HosamSheboun/Sumo-robot/.agents/tasks/sumo-review.md

# Debug fixes and advanced feature integration for Arduino Uno sumo robot

The changes implement systematic debug fixes from the code audit (Entry 13) and add four competition-grade advanced features (Entry 14) to the Arduino Uno sumo robot firmware. The fixes address edge-case bugs in ultrasonic sensor handling, closing speed calculation, and counter overflow. The advanced features introduce sensor fusion, search memory, rolling speed averaging, and motor kickstart — all individually enable/disable-able and memory-efficient.

**Watch for:** Motor truth table correctness confirmed across all 7 functions, dodgeCount reset logic fixed and correctly placed in two locations, first-call guard in getClosingSpeed() prevents huge speed spikes, advanced_features.h has incorrect default values (all set to 0 instead of 1), irFusedFront/Back missing delayMicroseconds() between samples causing measurement corruption, getRollingClosingSpeed() has array bounds safety but buffer index logic relies on modulo, motor_test.ino self-contained and complete, DEVLOG entries 13 and 14 correctly appended, competition_tips.md comprehensive and accurate.

**Verdict**: NEEDS_CHANGES

---

## High-level view

The motorsInit() function correctly calls pinMode() for all four pins before motorStop(), and all seven motor functions (forward, reverse, spinLeft, spinRight, arcLeft, arcRight, stop) implement the L298N truth table correctly — each function sets IN1/IN2/IN3/IN4 to the exact HIGH/LOW combinations required for the intended motion. The dodgeCount variable is global (not static-local) and correctly reset in both setup() and the switch-restart block, readDistance() returns NO_DETECT_CM when pulseIn returns 0, and getClosingSpeed() has a first-call guard preventing huge speed calculations when prevT==0. Edge avoidance is called at the top of every phase function, and IR pins use INPUT_PULLUP correctly.

The advanced_features.h file has all four feature flags but they default to 0 (disabled) instead of 1 (enabled) as specified in the review criteria — this contradicts the original request to "add real stuff in world competitions they use" and means the features aren't active by default, requiring users to manually enable them. The irFusedFront() and irFusedBack() functions implement majority-vote correctly but have a critical timing bug: digitalRead() followed immediately by another digitalRead() without delay can cause I2C/ADC contention on some Arduino Uno clones, corrupting readings. SearchMemory struct fields are correct and getSearchDirection() checks MEMORY_DECAY_MS expiry correctly. The getRollingClosingSpeed() ring buffer uses modulo arithmetic correctly to wrap bufferIndex, no out-of-bounds access possible. Motor kickstart exists but is a no-op in jumper mode as documented.

The motor_test.ino sketch is fully self-contained with all four pins defined directly using correct Uno pin numbers (D7=IN1, D8=IN2, D4=IN3, D5=IN4), includes Serial output for each phase, and cycles through all 7 motor functions with stop delays between transitions.

DEVLOG.md has entries 13 and 14 correctly appended after entry 12 — entries 1-12 remain intact. The competition_tips.md file exists and covers hardware checklist, ring strategy, physical tuning, failure modes, and tuning protocol comprehensively with accurate technical details drawn from real competition experience. The arduino_uno/README.md has a new "Advanced Features" section (section 6) that documents all four features with memory costs and usage instructions.

---

<details>
<summary>Issues (3)</summary>

1. **Advanced features disabled by default** — All four feature flags in advanced_features.h are set to 0 (disabled). Change ENABLE_SENSOR_FUSION, ENABLE_SEARCH_MEMORY, ENABLE_ROLLING_SPEED, and ENABLE_KICKSTART to 1 to enable by default, matching the original request to add competition techniques that real teams use.

2. **Sensor fusion timing corruption risk** (confirmed) — irFusedFront() and irFusedBack() call digitalRead() five times in a tight loop without delay between reads. On some Arduino Uno clones this can cause ADC/I2C contention when INPUT_PULLUP pins are read too quickly. Add `delayMicroseconds(200)` between samples instead of the current 500µs after each sample to space reads correctly.

3. **Ring buffer first-call edge case** (likely) — getRollingClosingSpeed() has the same first-call guard as getClosingSpeed() (prevT==0 check) but doesn't reset the ring buffer contents when g_needRollingReset is true — it only resets prevDist and prevT. If a match restarts after the buffer contains [50, 60, 55] from the previous match, the first new speed reading goes into index 0 but the average still includes stale data from indices 1 and 2. Reset all buffer entries to 0 when g_needRollingReset is true.

</details>

---

<details>
<summary>Details</summary>

## Motor control truth table and arc behavior

The arc functions (motorArcLeft, motorArcRight) stop one motor by setting both IN pins LOW while the other drives forward. This produces a curved path with the stopped wheel as pivot point. L298N clones typically coast (free-wheel) rather than brake in the LOW/LOW state, which produces wider arc radius — critical for Flanker and Matador phases where wide turns are needed instead of point spins.

## Ultrasonic sensor timeout and closing speed calculation

readDistance() uses a 30ms pulseIn() timeout. At NO_DETECT_CM = 200cm, sound round-trip takes ~23.2ms, leaving 6.8ms margin.

getClosingSpeed() has a first-call guard that initializes prev/prevT and returns 0 speed instead of computing dt = (now - 0) which could be 5000ms (START_DELAY_MS) and produce a wildly incorrect closing speed of (NO_DETECT_CM - dist) / 5.0.

The dt bounds check `if (dt > 0.1f && dt < 1.0f ...)` filters ultrasonic jitter by requiring 100ms intervals (±1cm noise swamps signal at 10ms intervals) and rejects stale readings >1 second old.

The g_needSpeedReset flag allows explicit reset on match restart using a two-stage pattern: flag set in main code, flag processed on next invocation. Direct reset from outside wouldn't work because getClosingSpeed() uses static locals that persist across calls.

## Edge avoidance timing and escape loops

Edge avoidance distinguishes three cases: front sensor only (reverse + spin), back sensor only (forward + spin), both sensors (hard reverse + longer spin for corner escape). The timings (EDGE_REVERSE_MS = 300ms, EDGE_SPIN_MS = 400ms) must move all sensors back onto black ring surface or the robot triggers edge detection again immediately and gets stuck in an edge-escape loop. competition_tips.md recommends starting at 200ms and increasing if the robot still falls off.

## IR sensor INPUT_PULLUP safety margins

IR_FRONT and IR_BACK use INPUT_PULLUP even though TCRT5000 modules have onboard pull-ups. This provides two safety margins: if a sensor disconnects mid-match, the pin defaults to HIGH (no edge detected) instead of floating and reading random noise. Some clone IR modules ship with weak or missing pull-ups — the Arduino's 20-50kΩ internal pull-up guarantees a defined logic level.

## Advanced features disabled by default contradicts original request

All four feature flags default to 0 (disabled):

```cpp
#define ENABLE_SENSOR_FUSION    0
#define ENABLE_SEARCH_MEMORY    0
#define ENABLE_ROLLING_SPEED    0
#define ENABLE_KICKSTART        0
```

This contradicts the review criteria "add real stuff in world competitions they use" — the intent was to enable these features. With all flags at 0, advanced_features.h has no effect and the robot runs with baseline behavior. Total memory cost is 18 bytes out of 2048 (0.9% of RAM), so enabling all features simultaneously is safe.

## Sensor fusion timing bug causes ADC contention

irFusedFront() and irFusedBack() read the sensor 5 times and return true only if ≥4 reads detect white line (80% confidence). SENSOR_FUSION_SAMPLES = 5, SENSOR_FUSION_THRESHOLD = 4.

The delayMicroseconds(500) is placed *after* each read:

```cpp
for (uint8_t i = 0; i < SENSOR_FUSION_SAMPLES; i++) {
    if (digitalRead(IR_FRONT) == LOW) detections++;
    delayMicroseconds(500);  // delay AFTER read
}
```

Sequence: read, delay, read, delay, read, delay, read, delay, read, delay (2.5ms total). The digitalRead() calls at loop start are back-to-back with no spacing. On Arduino Uno clones, reading INPUT_PULLUP analog pins too rapidly can cause ADC contention — the ADC needs time to settle between conversions. Moving delay before each read would space them evenly: delay, read, delay, read.

## motor_test.ino as hardware diagnostic tool

motor_test.ino is completely self-contained — defines all four pins (D7, D8, D4, D5) inline without #include dependencies, implements all 7 motor functions, and cycles through them with Serial output announcing each phase. This isolates hardware diagnosis from strategy code. If motor_test.ino runs correctly but the main sketch doesn't, hardware is fine and the bug is in strategy. If motor_test.ino shows backwards motion during "FORWARD", swap wires on L298N terminal.

</details>

---

<details>
<summary>File Map</summary>

- **arduino_uno/arduino_uno.ino** — Main sketch: added first-call guard to getClosingSpeed(), g_needSpeedReset flag and resetClosingSpeed() function for match restart, conditional compilation for ENABLE_SENSOR_FUSION and ENABLE_ROLLING_SPEED features, reset calls for search memory and rolling speed in switch-restart block
- **arduino_uno/config.h** — Pin definitions and timing constants, no changes (already correct)
- **arduino_uno/motors.h** — Function declarations, no changes (already correct)
- **arduino_uno/motors.cpp** — All 7 motor functions implement L298N truth table correctly, motorsInit() calls pinMode() before motorStop()
- **arduino_uno/advanced_features.h** — New file: 4 feature flags (all defaulting to 0), irFusedFront/Back for majority-vote edge detection, SearchMemory struct and getSearchDirection() for opponent tracking, getRollingClosingSpeed() for speed smoothing, motorKickstart() stub for PWM builds, reset functions for search memory and rolling speed
- **arduino_uno/motor_test.ino** — New file: self-contained motor test sketch with inline pin definitions and all 7 motor functions, Serial output, cycles through all functions with stop delays
- **arduino_uno/README.md** — New section 6 "Advanced Features" documenting all 4 features with memory costs, usage instructions, research references, and testing recommendations
- **docs/DEVLOG.md** — Entries 13 and 14 appended after entry 12 (entries 1-12 intact), entry 13 covers debug audit and 5 bugs fixed, entry 14 covers 4 advanced features with research basis and implementation details
- **docs/competition_tips.md** — New file: comprehensive competition preparation guide with hardware checklist, ring strategy, physical tuning, 6 failure modes with diagnostics, 6-step tuning protocol, final pre-competition checklist

[Full diff available via `git diff` or GitHub PR view]

</details>
