HosamSheboun/Sumo-robot/Sumo_Robot_V2_3D_files/Sumo_Box_Exterior_v2.png

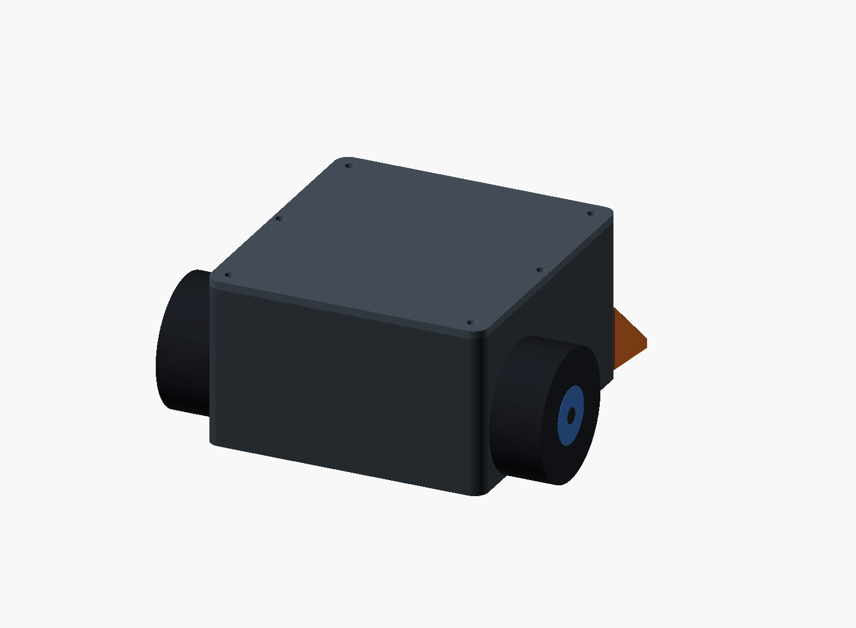
Sumo_Robot_V2_3D_files/Sumo_Box_Exterior_v2.png
