HosamSheboun/Sumo-robot/Sumo_Robot_V2_3D_files/Sumo_Box_Side_Profile_v2.png

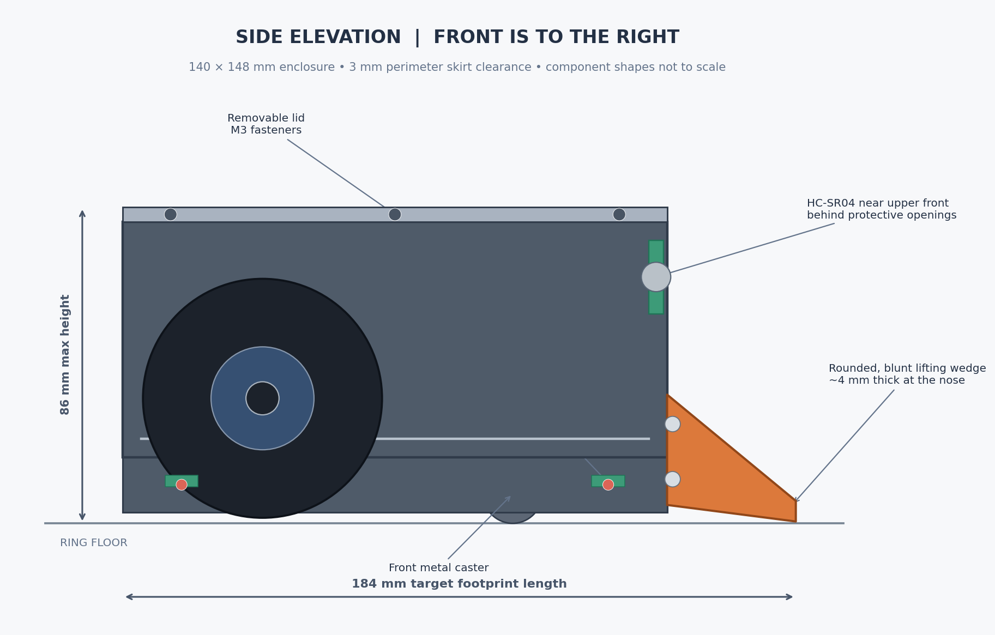
Sumo_Robot_V2_3D_files/Sumo_Box_Side_Profile_v2.png
