HosamSheboun/Sumo-robot/Sumo_Robot_V2_3D_files/Sumo_Box_Chassis_v2.stl

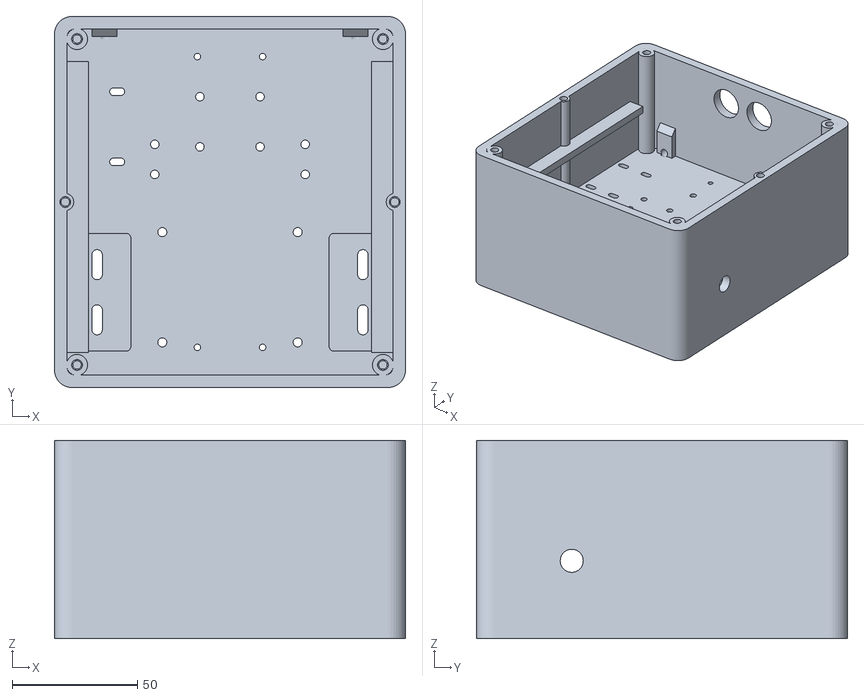
[picture p5: CAD file, 2026-10-29]
Sumo_Robot_V2_3D_files/Sumo_Box_Chassis_v2.stl
140.0 x 148.0 x 79.0
