HosamSheboun/Sumo-robot/Sumo_Robot_V2_3D_files/Sumo_Front_Blade_v2.stl

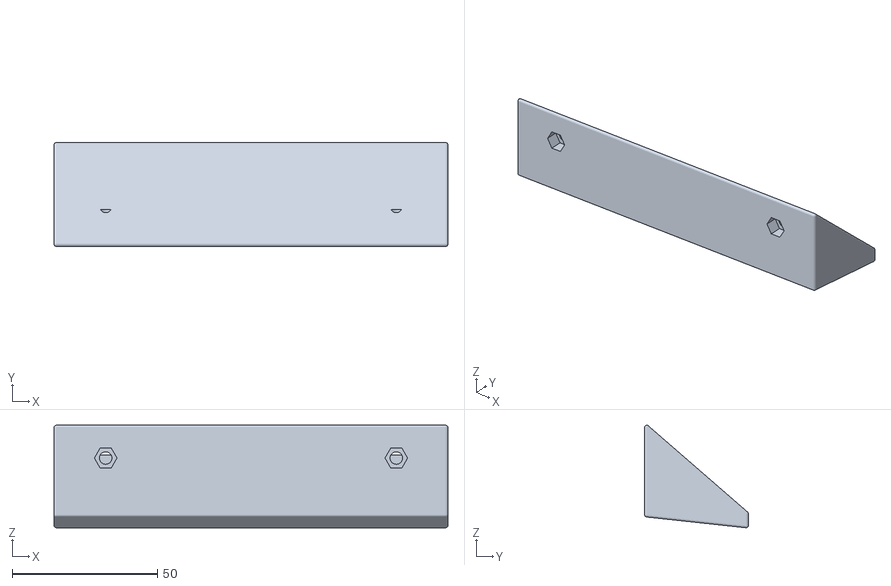
[picture p6: CAD file, 2026-10-29]
Sumo_Robot_V2_3D_files/Sumo_Front_Blade_v2.stl
135.6 x 35.8 x 35.3
