HosamSheboun/Sumo-robot/Sumo_Robot_V2_3D_files/Sumo_Electronics_Tray_v2.stl

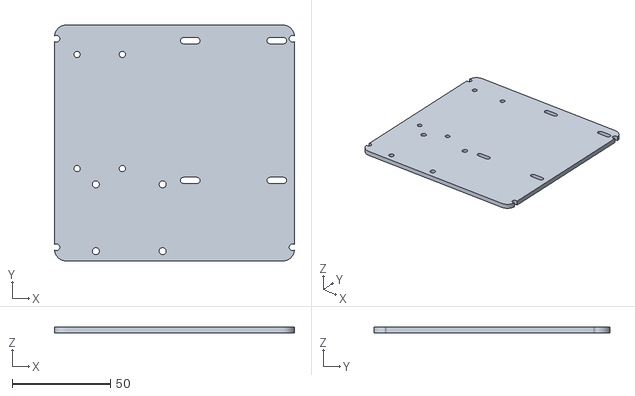
[picture p7: CAD file, 2026-10-29]
Sumo_Robot_V2_3D_files/Sumo_Electronics_Tray_v2.stl
122.0 x 120.0 x 3.00
