HosamSheboun/Sumo-robot/Sumo_Robot_V2_3D_files/Sumo_Box_Lid_v2.stl

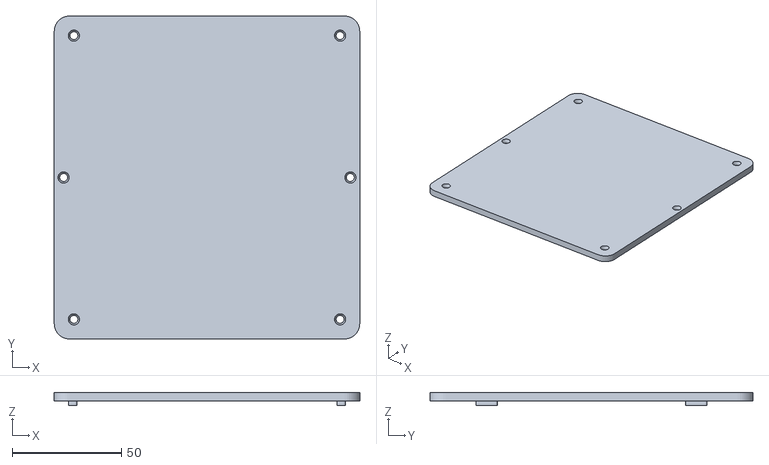
[picture p8: CAD file, 2026-10-29]
Sumo_Robot_V2_3D_files/Sumo_Box_Lid_v2.stl
140.0 x 148.0 x 6.00
