HosamSheboun/Sumo-robot/(commit log)

2026-10-26 Ground zero
2026-10-29 let's goo
    [Sumo_Box_Chassis_v2.stl, Sumo_Box_Concept_v2.scad, Sumo_Box_Lid_v2.stl, Sumo_Electronics_Tray_v2.stl, Sumo_Front_Blade_v2.stl]
2026-10-29 button added
2026-10-30 arduino update
2026-10-30 arduino uno
2026-10-31 Minor changes to README files and motor configuration for ESP32 and Arduino boards.
2026-10-31 fix: address review findings - sensor fusion threshold, search memory direction tracking, state resets on match restart, arc motor documentation
    [advanced_features.h, arduino_uno.ino, motor_test.ino, motors.cpp]
2026-10-31 fix: add explicit reset mechanisms for closing speed calculations
    - Add resetClosingSpeed() with g_needSpeedReset flag to handle match restarts
    - Fix resetRollingSpeed() to use g_needRollingReset flag instead of fragile time-went-backwards heuristic
    - Both functions now properly reset static state when switch is toggled mid-session
    - Resolves review findings for match restart detection gaps
    [advanced_features.h, arduino_uno.ino]
